shritankomm/7-DOF-FDM-Open-Arm/DOCS.md

For now all progress regarding the mechanical design has been documented through the Macando documentation process, but any new updates regarding the actual creation of this project, whether mechanical or software related, will be put here. Feel free to check out this link which shows the current updates of the design up until I recieve funding

https://macondo.hackclub.com/projects/4741
