shritankomm/7-DOF-FDM-Open-Arm/PICTURES.md

Pictures of the finished arm assembly will be released soon
