shritankomm/7-DOF-FDM-Open-Arm/CAD/Onshape Link.md

This is the public Onshape link. To make edits, create a copy, but this is also a very straightforward place to download 3d files. 

https://cad.onshape.com/documents/1f080881992948429d140792/w/a94975f5bed906cc7d72d1d8/e/6cf5572cd40461716445cc53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
