shritankomm/7-DOF-FDM-Open-Arm/CAD/PartsList.md

**Total parts: 57**

1. 4040 extrusion
2. chest plate holder (2x)
3. chest plate (2x)
4. servo (16x)
5. left shoulder pitch adapter
6. left shoulder motor holder
7. left shoulder roll part
8. left arm yaw connector
9. left elbow to bicep motor connector
10. left bicep screw bar
11. left elbow pitch part
12. left forearm yaw part
13. left wrist pitch motor holder
14. left forearm screw bar
15. left wrist pitch to roll connector
16. left wrist holder
17. left top non stationary claw arm
18. left stationary claw arm
19. left bottom stationary claw arm
20. left shoulder pitch motor back plate
21. right shoulder pitch adapter
22. right shoulder motor holder
23. right shoulder roll part
24. right arm yaw connector
25. right elbow to bicep motor connector
26. right bicep screw bar
27. right elbow pitch part
28. right forearm yaw part
29. right wrist pitch motor holder
30. right forearm screw bar
31. right wrist pitch to roll connector
32. right wrist holder
33. right top non stationary claw arm
34. right stationary claw arm
35. right bottom stationary claw arm
36. right shoulder pitch motor back plate
