shritankomm/7-DOF-FDM-Open-Arm/CAD/STL Files/Full Assembly STL files (all parts)/full assembly with animation - wrist pitch to roll connector.stl

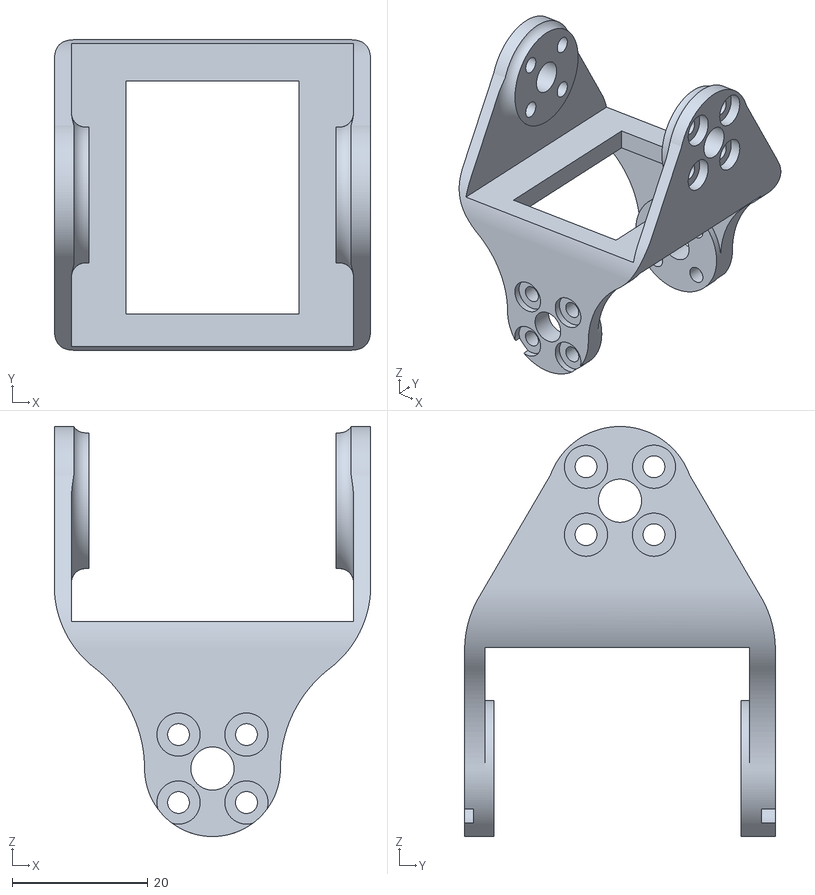
[picture p1: CAD file, 2026-06-12]
CAD/STL Files/Full Assembly STL files (all parts)/full assembly with animation - wrist pitch to roll connector.stl
46.6 x 45.7 x 60.3
