shritankomm/7-DOF-FDM-Open-Arm/CAD/STL Files/Full Assembly STL files (all parts)/full assembly with animation - stationary claw arm.stl

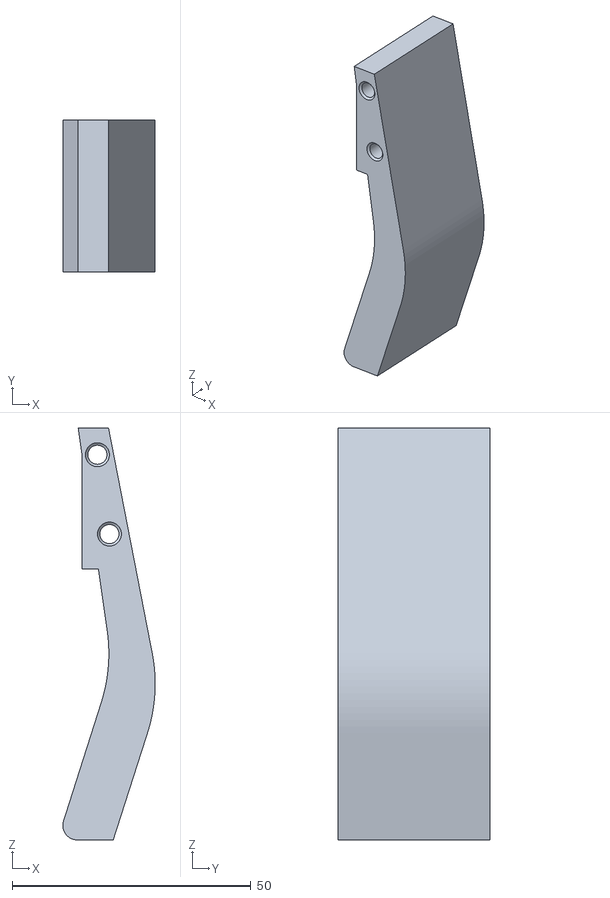
[picture p2: CAD file, 2026-06-12]
CAD/STL Files/Full Assembly STL files (all parts)/full assembly with animation - stationary claw arm.stl
19.3 x 31.8 x 86.3
