shritankomm/7-DOF-FDM-Open-Arm/CAD/STL Files/Full Assembly STL files (all parts)/full assembly with animation - elbow pitch part-Mirrored.stl

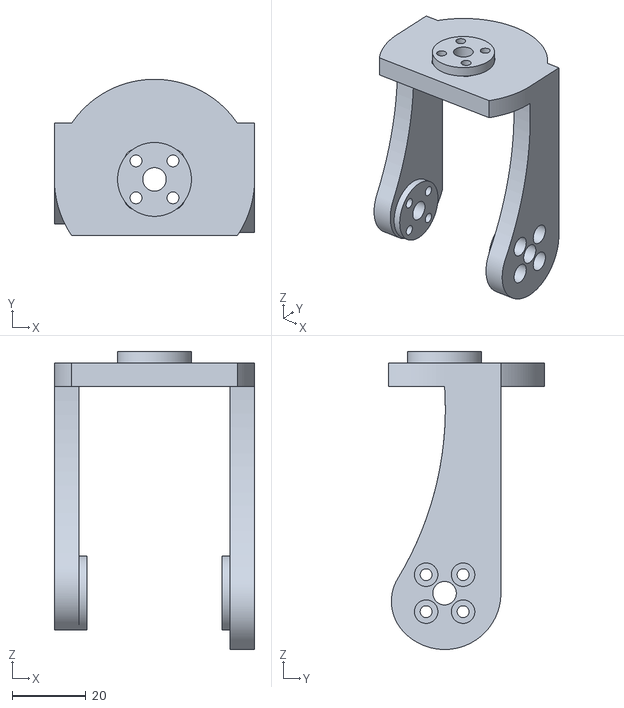
[picture p3: CAD file, 2026-06-12]
CAD/STL Files/Full Assembly STL files (all parts)/full assembly with animation - elbow pitch part-Mirrored.stl
54.2 x 42.3 x 80.6
