shritankomm/7-DOF-FDM-Open-Arm/CAD/STL Files/Full Assembly STL files (all parts)/full assembly with animation - shoulder roll part.stl

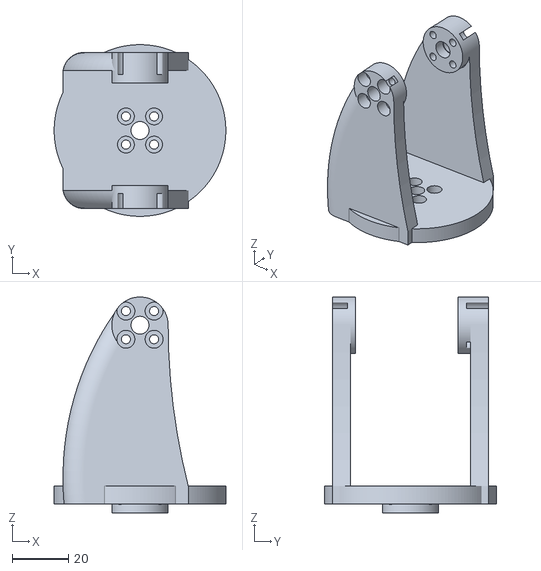
[picture p4: CAD file, 2026-06-12]
CAD/STL Files/Full Assembly STL files (all parts)/full assembly with animation - shoulder roll part.stl
61.0 x 61.0 x 76.7
