shritankomm/7-DOF-FDM-Open-Arm/CAD/STL Files/Full Assembly STL files (all parts)/full assembly with animation - shoulder pitch motor back plate.stl

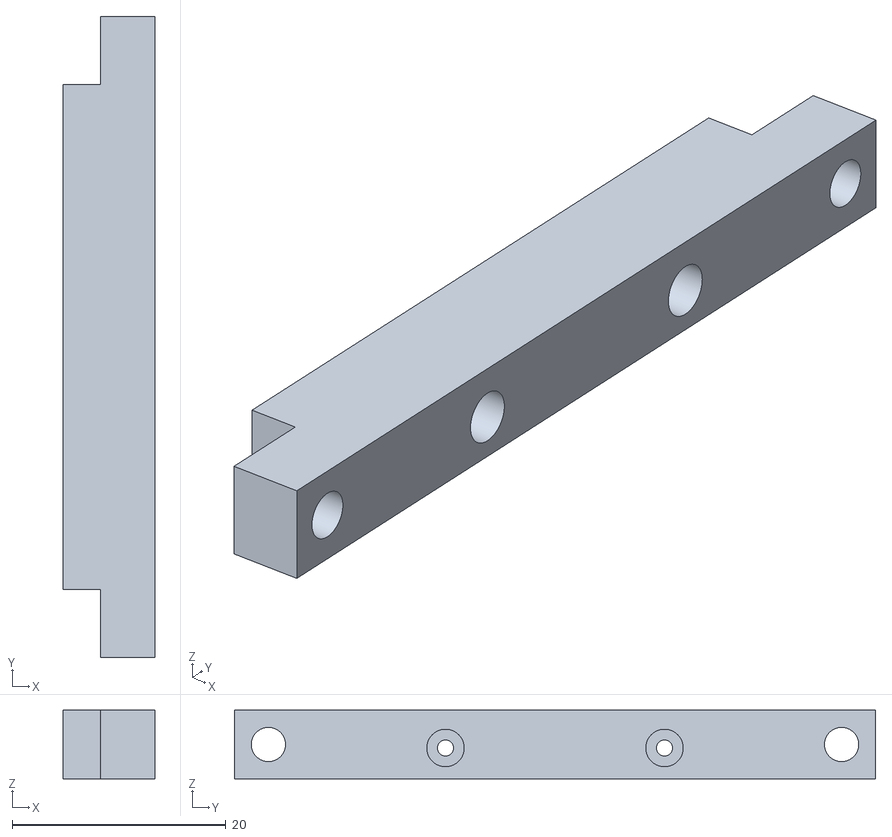
[picture p5: CAD file, 2026-06-12]
CAD/STL Files/Full Assembly STL files (all parts)/full assembly with animation - shoulder pitch motor back plate.stl
8.58 x 60.0 x 6.45
