shritankomm/7-DOF-FDM-Open-Arm/CAD/STL Files/Full Assembly STL files (all parts)/full assembly with animation - wrist pitch motor holder.stl

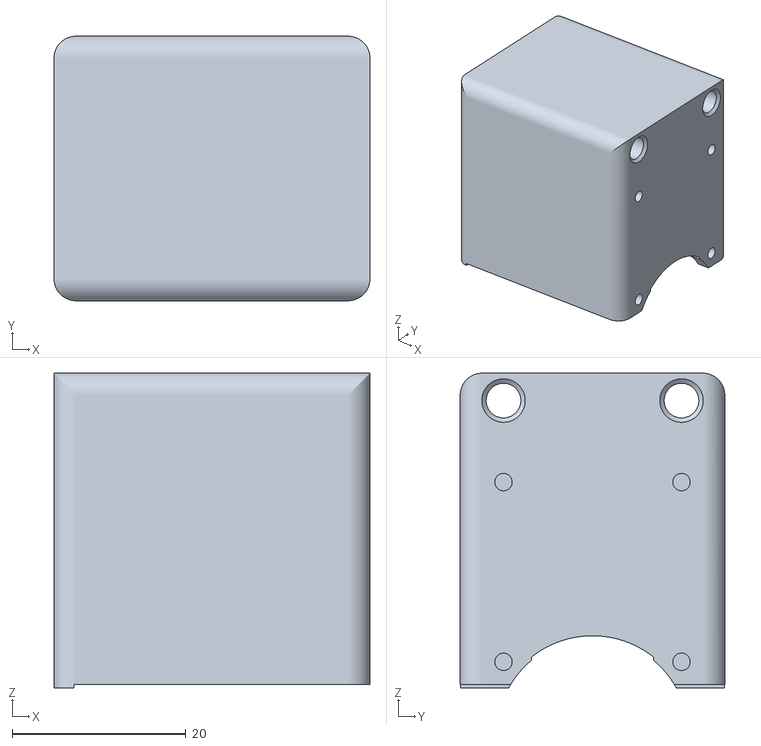
[picture p8: CAD file, 2026-06-12]
CAD/STL Files/Full Assembly STL files (all parts)/full assembly with animation - wrist pitch motor holder.stl
36.4 x 30.5 x 36.2
