shritankomm/7-DOF-FDM-Open-Arm/CAD/STL Files/Full Assembly STL files (all parts)/full assembly with animation - shoulder motor holder-Mirrored.stl

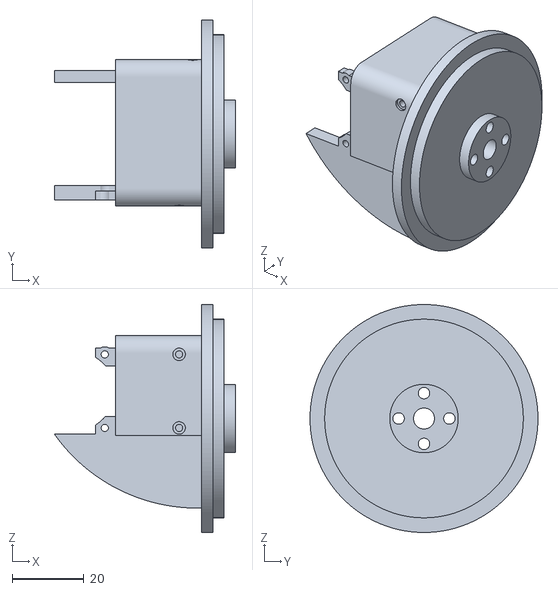
[picture p9: CAD file, 2026-06-12]
CAD/STL Files/Full Assembly STL files (all parts)/full assembly with animation - shoulder motor holder-Mirrored.stl
50.5 x 63.5 x 63.5
