shritankomm/7-DOF-FDM-Open-Arm/CAD/STL Files/Full Assembly STL files (all parts)/full assembly with animation - arm yaw connector-Mirrored.stl

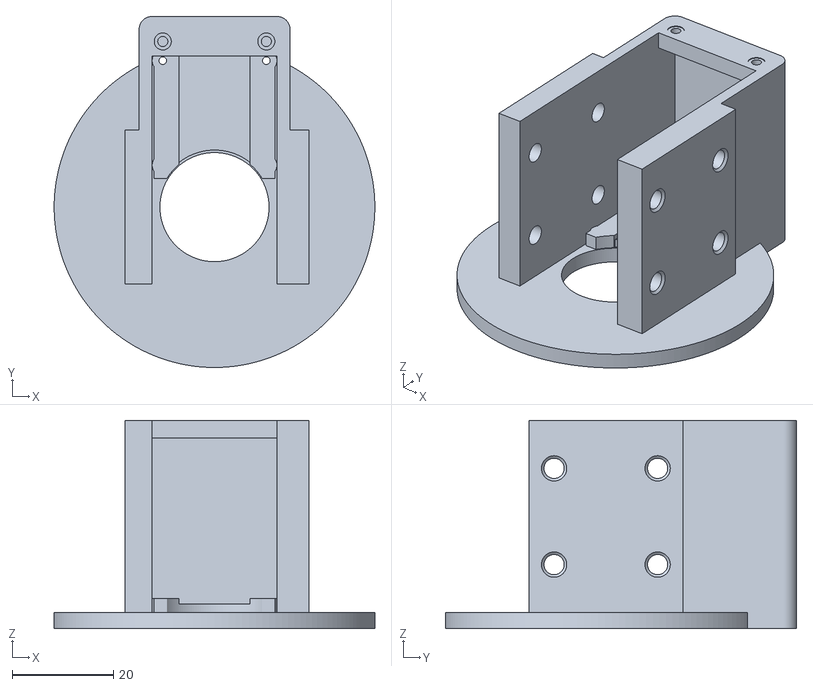
[picture p11: CAD file, 2026-06-12]
CAD/STL Files/Full Assembly STL files (all parts)/full assembly with animation - arm yaw connector-Mirrored.stl
63.5 x 69.5 x 41.3
