shritankomm/7-DOF-FDM-Open-Arm/CAD/STL Files/Full Assembly STL files (all parts)/full assembly with animation - elbow to bicep motor connector-Mirrored.stl

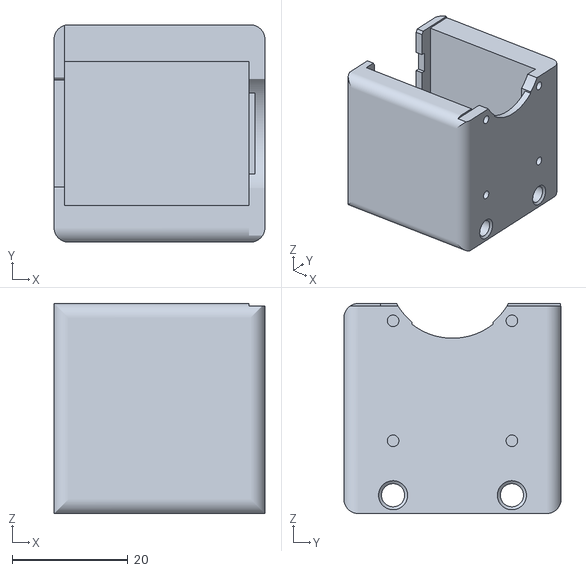
[picture p12: CAD file, 2026-06-12]
CAD/STL Files/Full Assembly STL files (all parts)/full assembly with animation - elbow to bicep motor connector-Mirrored.stl
36.4 x 37.5 x 36.3
