shritankomm/7-DOF-FDM-Open-Arm/CAD/STL Files/Full Assembly STL files (all parts)/full assembly with animation - bottom stationary claw arm.stl

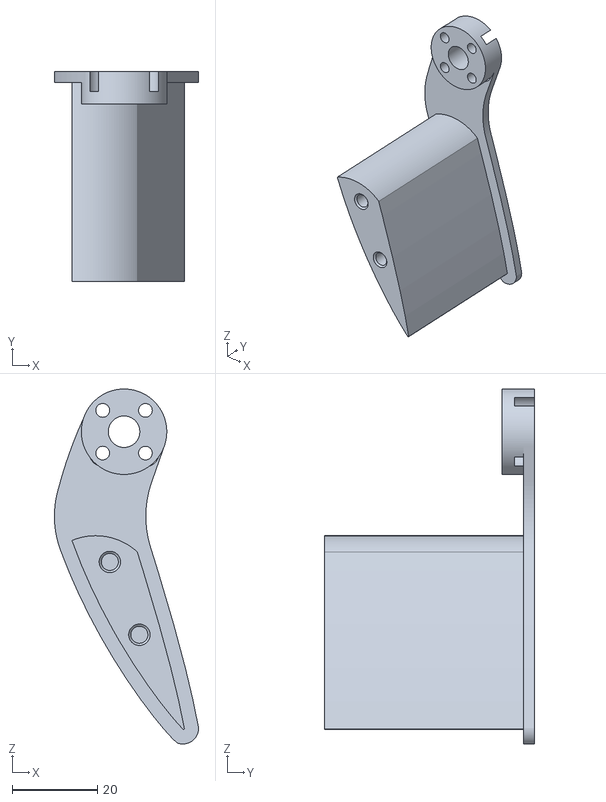
[picture p13: CAD file, 2026-06-12]
CAD/STL Files/Full Assembly STL files (all parts)/full assembly with animation - bottom stationary claw arm.stl
33.7 x 49.1 x 83.1
