shritankomm/7-DOF-FDM-Open-Arm/CAD/STL Files/Full Assembly STL files (all parts)/full assembly with animation - shoulder pitch adapter.stl

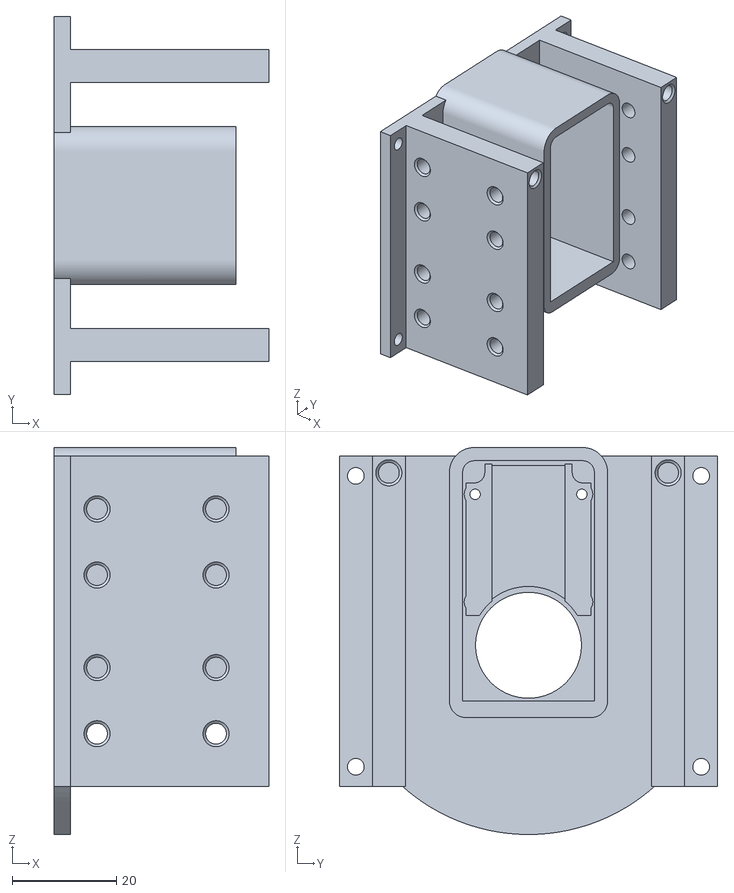
[picture p15: CAD file, 2026-06-12]
CAD/STL Files/Full Assembly STL files (all parts)/full assembly with animation - shoulder pitch adapter.stl
41.3 x 72.7 x 74.3
