shritankomm/7-DOF-FDM-Open-Arm/CAD/STL Files/Full Assembly STL files (all parts)/full assembly with animation - 4040 extrusion.stl

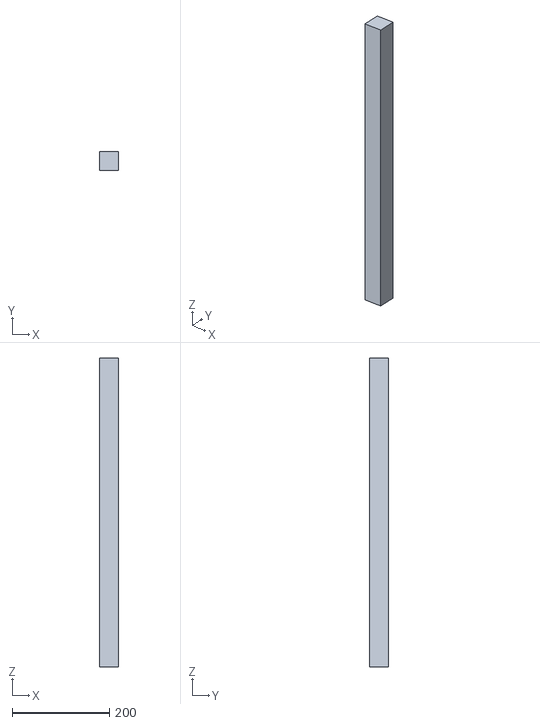
[picture p16: CAD file, 2026-06-12]
CAD/STL Files/Full Assembly STL files (all parts)/full assembly with animation - 4040 extrusion.stl
40.0 x 40.0 x 635.0
