shritankomm/7-DOF-FDM-Open-Arm/CAD/StepFiles/Center Parts.step

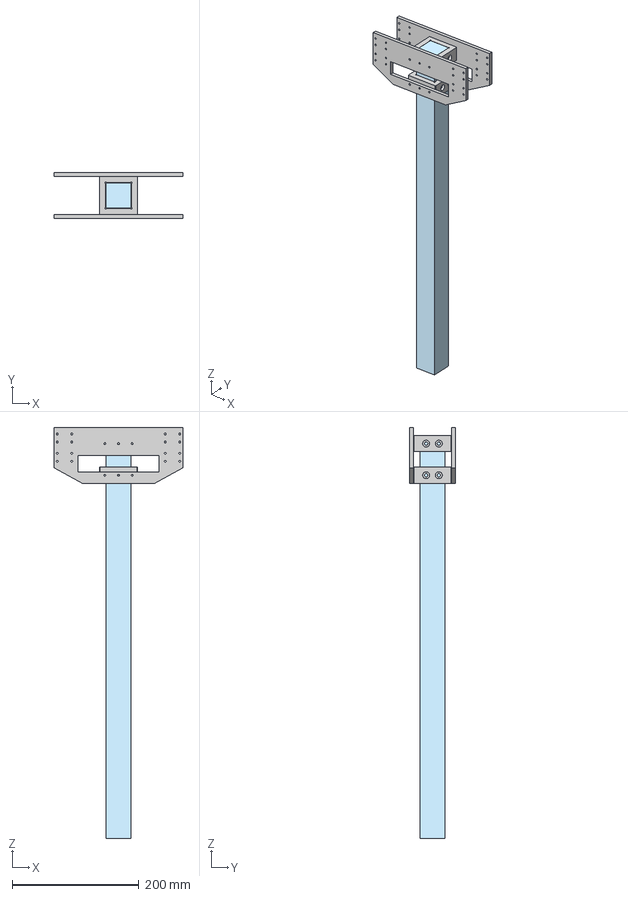
[picture p18: CAD file, 2026-06-10]
CAD/StepFiles/Center Parts.step
203.2 x 72.7 x 647.7 mm
4040 extrusion
chest plate holder x 2
chest plate x 2
