shritankomm/7-DOF-FDM-Open-Arm/(list of files, cad)

Other CAD files:
CAD/STL Files/Full Assembly STL files (all parts)/full assembly with animation - top non stationary claw arm-Mirrored.stl
CAD/STL Files/Full Assembly STL files (all parts)/full assembly with animation - wrist pitch to roll connector-Mirrored.stl
CAD/STL Files/Full Assembly STL files (all parts)/full assembly with animation - elbow pitch part.stl
CAD/STL Files/Full Assembly STL files (all parts)/full assembly with animation - shoulder roll part-Mirrored.stl
CAD/STL Files/Full Assembly STL files (all parts)/full assembly with animation - elbow to bicep motor connector.stl
CAD/STL Files/Full Assembly STL files (all parts)/full assembly with animation - bottom stationary claw arm-Mirrored.stl
CAD/STL Files/Full Assembly STL files (all parts)/full assembly with animation - wrist holder-Mirrored.stl
CAD/STL Files/Full Assembly STL files (all parts)/full assembly with animation - forearm yaw part-Mirrored.stl
CAD/STL Files/Full Assembly STL files (all parts)/full assembly with animation - shoulder motor holder.stl
CAD/STL Files/Full Assembly STL files (all parts)/full assembly with animation - arm yaw connector.stl
CAD/StepFiles/All Parts.step
CAD/STL Files/Full Assembly STL files (all parts)/full assembly with animation - bicep screw bar (1).stl
CAD/STL Files/Full Assembly STL files (all parts)/full assembly with animation - bicep screw bar.stl
CAD/STL Files/Full Assembly STL files (all parts)/full assembly with animation - chest plate (1).stl
CAD/STL Files/Full Assembly STL files (all parts)/full assembly with animation - forearm screw bar (1).stl
CAD/STL Files/Full Assembly STL files (all parts)/full assembly with animation - forearm screw bar.stl
