shritankomm/7-DOF-FDM-Open-Arm/CAD/FileFindingGuide.md

There are four STEP files located in the STEP folder, and there is also an STL folder, which contains every individual part as an STL file for easy printing.

**For the STL files, if the part says mirrored, then it is a part of the right arm, and if it doesn't say anything, it is either a part of the left arm or perfectly symmetrical when mirrored over. Best way to print with this is to download all the files and then print them 1 by 1 but the servos can be ignored; those don't need to be printed.**

the **All Parts.STEP file** contains all 57 parts, including the right arm, left arm, and middle body assemblies. ⬇⬇


The **Right Arm Parts.STEP file** contains all the parts tied to the right side arm assembly and can be downloaded and assembled on its own to make slicing simpler. ⬇⬇



The **Left Arm Parts.STEP file** contains all the parts tied to the left side arm assembly and can be downloaded and assembled on its own to make slicing simpler. ⬇⬇



The **Center Parts.STEP file** contains the chest plates, 4040 extrusion, and the chest plate holders ⬇⬇
