shritankomm/7-DOF-FDM-Open-Arm/(commit log)

2026-06-10 Create BOM
    bill of materials
2026-06-10 Create BOM.md
    An extensive BOM with a list of needed parts
2026-06-10 Create CAD
2026-06-10 Add CAD files
    [Center Parts.step]
2026-06-12 Rename CAD/All Parts.step to CAD/StepFiles/All Parts.step
    [All Parts.step]
2026-06-12 Rename CAD/Center Parts.step to CAD/StepFiles/Center Parts.step
    [Center Parts.step]
2026-06-12 Add STL files
    [full assembly with animation - 4040 extrusion.stl, full assembly with animation - arm yaw connector-Mirrored.stl, full assembly with animation - arm yaw connector.stl, full assembly with animation - bicep screw bar (1).stl, full assembly with animation - bicep screw bar.stl, full assembly with animation - bottom stationary claw arm-Mirrored.stl, full assembly with animation - bottom stationary cl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]
2026-09-02 Update README with assembly instructions clarification
